ray979/ANT-Automated-Nutrient-Technique/ANT_System/automation.py

import RPi.GPIO as GPIO
import phsensor
import ecsensor
import sys
import time
import re
import serial

PH_SENSOR_PIN = 0
EC_SENSOR_PIN = 1

PH_UP = 12
PH_DOWN = 16

PH_MIN = 5.5
PH_MAX = 7

EC_A = 24
EC_B = 25
EC_MIN = 1.2

#ser=serial.Serial('/dev/ttyACM0', 115200)

#GPIO Setup for Mechanical Relay Pins
def GPIOSetup():
    GPIO.setup(PH_UP, GPIO.OUT, initial = GPIO.HIGH)
    GPIO.setup(PH_DOWN, GPIO.OUT, initial = GPIO.HIGH)
    GPIO.setup(EC_A, GPIO.OUT, initial = GPIO.HIGH)
    GPIO.setup(EC_B, GPIO.OUT, initial = GPIO.HIGH)

#GPIO Setup for Solid State Relay Pins    
def GPIOSetup_SS():
    GPIO.setup(PH_UP, GPIO.OUT, initial = GPIO.LOW)
    GPIO.setup(PH_DOWN, GPIO.OUT, initial = GPIO.LOW)
    GPIO.setup(EC_A, GPIO.OUT, initial = GPIO.LOW)
    GPIO.setup(EC_B, GPIO.OUT, initial = GPIO.LOW)

def ph_balancing(ph_reading,ph_min,ph_max):
    #ph sensing from ad da board
    ph = round(ph_reading,1)

    #if ph level is below range
    if ph < ph_min:
        #turn on PH up pump
        GPIO.output(PH_UP, GPIO.LOW)
        print(f"PH UP pump on at PH:{ph}")
        #time.sleep(pump duration)
        time.sleep(1)
        #turn off PH up pump
        GPIO.output(PH_UP, GPIO.HIGH)
        print("PH UP pump off")
        return 1

    #if ph level is above range
    if ph > ph_max:
        #turn on PH down pump
        GPIO.output(PH_DOWN, GPIO.LOW)
        print(f"PH DOWN pump on at PH:{ph}")
        #time.sleep(pump duration)
        time.sleep(1)
        #turn off PH down pump
        GPIO.output(PH_DOWN, GPIO.HIGH)
        print("PH DOWN pump off")
        return 2

    return 0
        
def ph_balancing_ss(ph_reading,ph_min,ph_max):
    #ph sensing from ad da board
    ph = round(ph_reading,1)

    #if ph level is below range
    if ph < ph_min:
        #turn on PH up pump
        GPIO.output(PH_UP, GPIO.HIGH)
        print(f"PH UP pump on at PH:{ph}")
        #time.sleep(pump duration)
        time.sleep(1)
        #turn off PH up pump
        GPIO.output(PH_UP, GPIO.LOW)
        print("PH UP pump off")

    #if ph level is above range
    if ph > ph_max:
        #turn on PH down pump
        GPIO.output(PH_DOWN, GPIO.HIGH)
        print(f"PH DOWN pump on at PH:{ph}")
        #time.sleep(pump duration)
        time.sleep(1)
        #turn off PH down pump
        GPIO.output(PH_DOWN, GPIO.LOW)
        print("PH DOWN pump off")
'''
def EC_Reading():
    #open serial port
    SensorData = str(ser.readline().decode("utf-8")).split(' ')
    if (len(SensorData) > 1):

        pattern = re.compile(r"[-]?[\d]+[.]?[\d]+") #real expression: Find numerical value in form "xx.xx"

        try:
            temp_value = float(pattern.search(SensorData[0]).group()) #apply real expression to serial data
            ec_value = float(pattern.search(SensorData[1]).group())
            return ec_value
            #print(f'Temperature:{temp_value} EC:{ec_value}')
        except AttributeError as e: #if real expression return None
            print(e)
'''

def EC_balancing(EC_reading,EC_min):
    #if EC level is below range, turn on pump
    if EC_reading < EC_min:
        #turn on EC pumps
        GPIO.output(EC_A, GPIO.LOW)
        print("EC: ", EC_reading, "\nStarting pump for Solution A")
        time.sleep(1)
        GPIO.output(EC_A, GPIO.HIGH)
        print("Solution A pump off")

        time.sleep(180) # three minute for concentrate to mix

        #then Solution B
        GPIO.output(EC_B, GPIO.LOW)
        print("Starting pump for Solution B")
        time.sleep(2)
        GPIO.output(EC_B, GPIO.HIGH)
        print("Solution B pump off")
        return 1
    return 0

def light_test():
    
    GPIO.output(5, GPIO.HIGH)

if __name__ == '__main__':
    try:
        GPIO.setmode(GPIO.BCM)
        GPIOSetup_SS()
        ph_sensor = phsensor.PHSensor(0,14) #phsensor object
        ec_sensor = ecsensor.ECSensor() #ec object
        while True:
            ph_balancing_ss(ph_sensor.read_ph(PH_SENSOR_PIN),PH_MIN,PH_MAX)
            EC_balancing(ec_sensor.readEC(EC_SENSOR_PIN), EC_MIN)
    except KeyboardInterrupt:
        GPIO.cleanup()
        sys.exit('PH and EC balancing ended')
