ray979/ANT-Automated-Nutrient-Technique/(commit log)

2021-10-19 Added Sensor folder
2021-10-20 PH sensor python code added
2021-10-24 Add ph calibration method, ph probe recalibrated
2021-10-24 Update automation pump pin and ph sensing interval
2021-10-27 Create EC Sensor + Temp Probe for Arduino
    This code is for the DFRobot EC Sensor + GikFun DS18B20 Waterproof Temperature Probe. Libraries and test code provided by DFRobot and Arduino.
    EC Sensor:
    https://wiki.dfrobot.com/Gravity__Analog_Electrical_Conductivity_Sensor___Meter_V2__K%3D1__SKU_DFR0300
    Temperature Probe:
    https://create.arduino.cc/projecthub/TheGadgetBoy/ds18b20-digital-temperature-sensor-and-arduino-9cc806
2021-11-07 Edit ph calibration method
2021-11-19 Add threads in main, run ph sensing and automation concurrently
2021-11-19 added global ph due to sometimes conflict during read same analog pin
2021-11-20 Add files via upload
    Links for libraries:
    EC Sensor Arduino Libraries:
    https://github.com/DFRobot/DFRobot_EC/archive/master.zip
    DS18B20 Arduino Libraries:
    https://github.com/milesburton/Arduino-Temperature-Control-Library
    https://www.arduino.cc/reference/en/libraries/ds18b20/
    https://hacksterio.s3.amazonaws.com/uploads/attachments/229743/OneWire.zip
2021-11-21 Create Sensor Libraries.readme
2021-11-21 Rename Sensor Libraries.readme to Sensor Libraries README
2021-11-21 Comment out light cycle thread for later
2021-11-26 Remove internal 60s delay for ph automation and update main2 with additional ec sensing method/thread
2021-11-29 Recalibrated ph probe and entered correct GPIO Pins for automation
    [automation.py, config.py]
2022-01-25 Updated main2.py for EC sensor on ADC Board
2022-01-28 fixed sensor value fluctuation/accessing ADC at the same time, added files for FASTAPI 'web app'
    [main.py, main2.py]
2022-02-06 Probable fix to light cycle premature shutoff at startup. Moved all GPIOsetup to main
    [automation.py, main2.py]
2022-02-15 folder for Nodered flow
2022-02-25 Switch PH pins again
2022-02-26 Added method to add sensor data into database
    Method for adding sensor data through fastapi endpoint
2022-02-28 Saving Sensor Reading to Database Proto
    Save sensor reading during start of automation cycle every 30 minutes
2022-03-09 Nodered flow with tab buttons
2022-03-09 Updated NodeRed flow v2
    Removed redundant settings send with NULL values
